dl1bz/NepControl100W/HF-100W-PA-cased-v.2.3.pdf

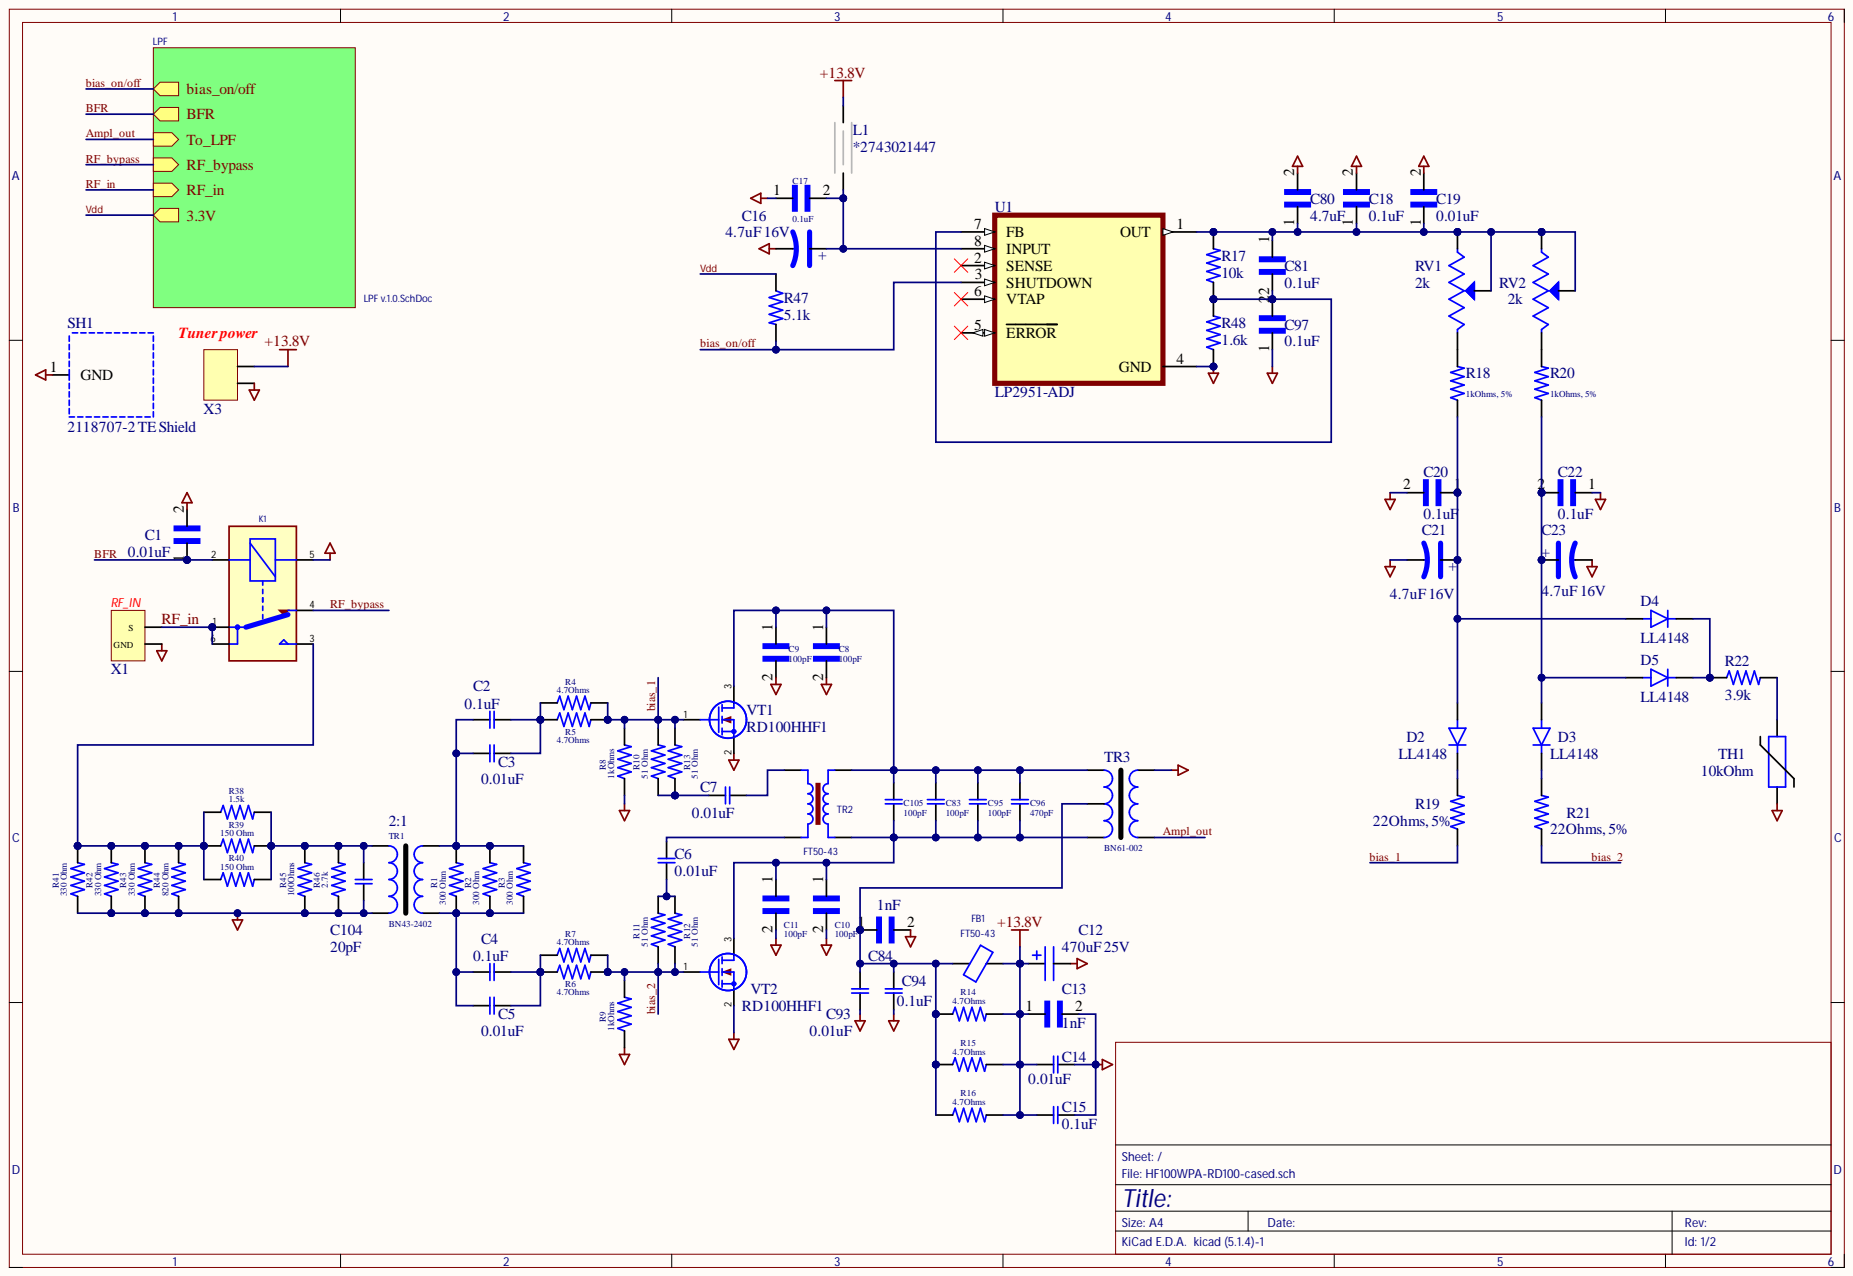
[picture p1: page 1]

SENSE 2

R47 5.1k | | VTAP 6

C105 | C83 | C95
100pF | 100pF | 100pF | 470pF

Size: A4 | Date: | Rev:
KiCad E.D.A. kicad (5.1.4)-1 | | Id: 1/2

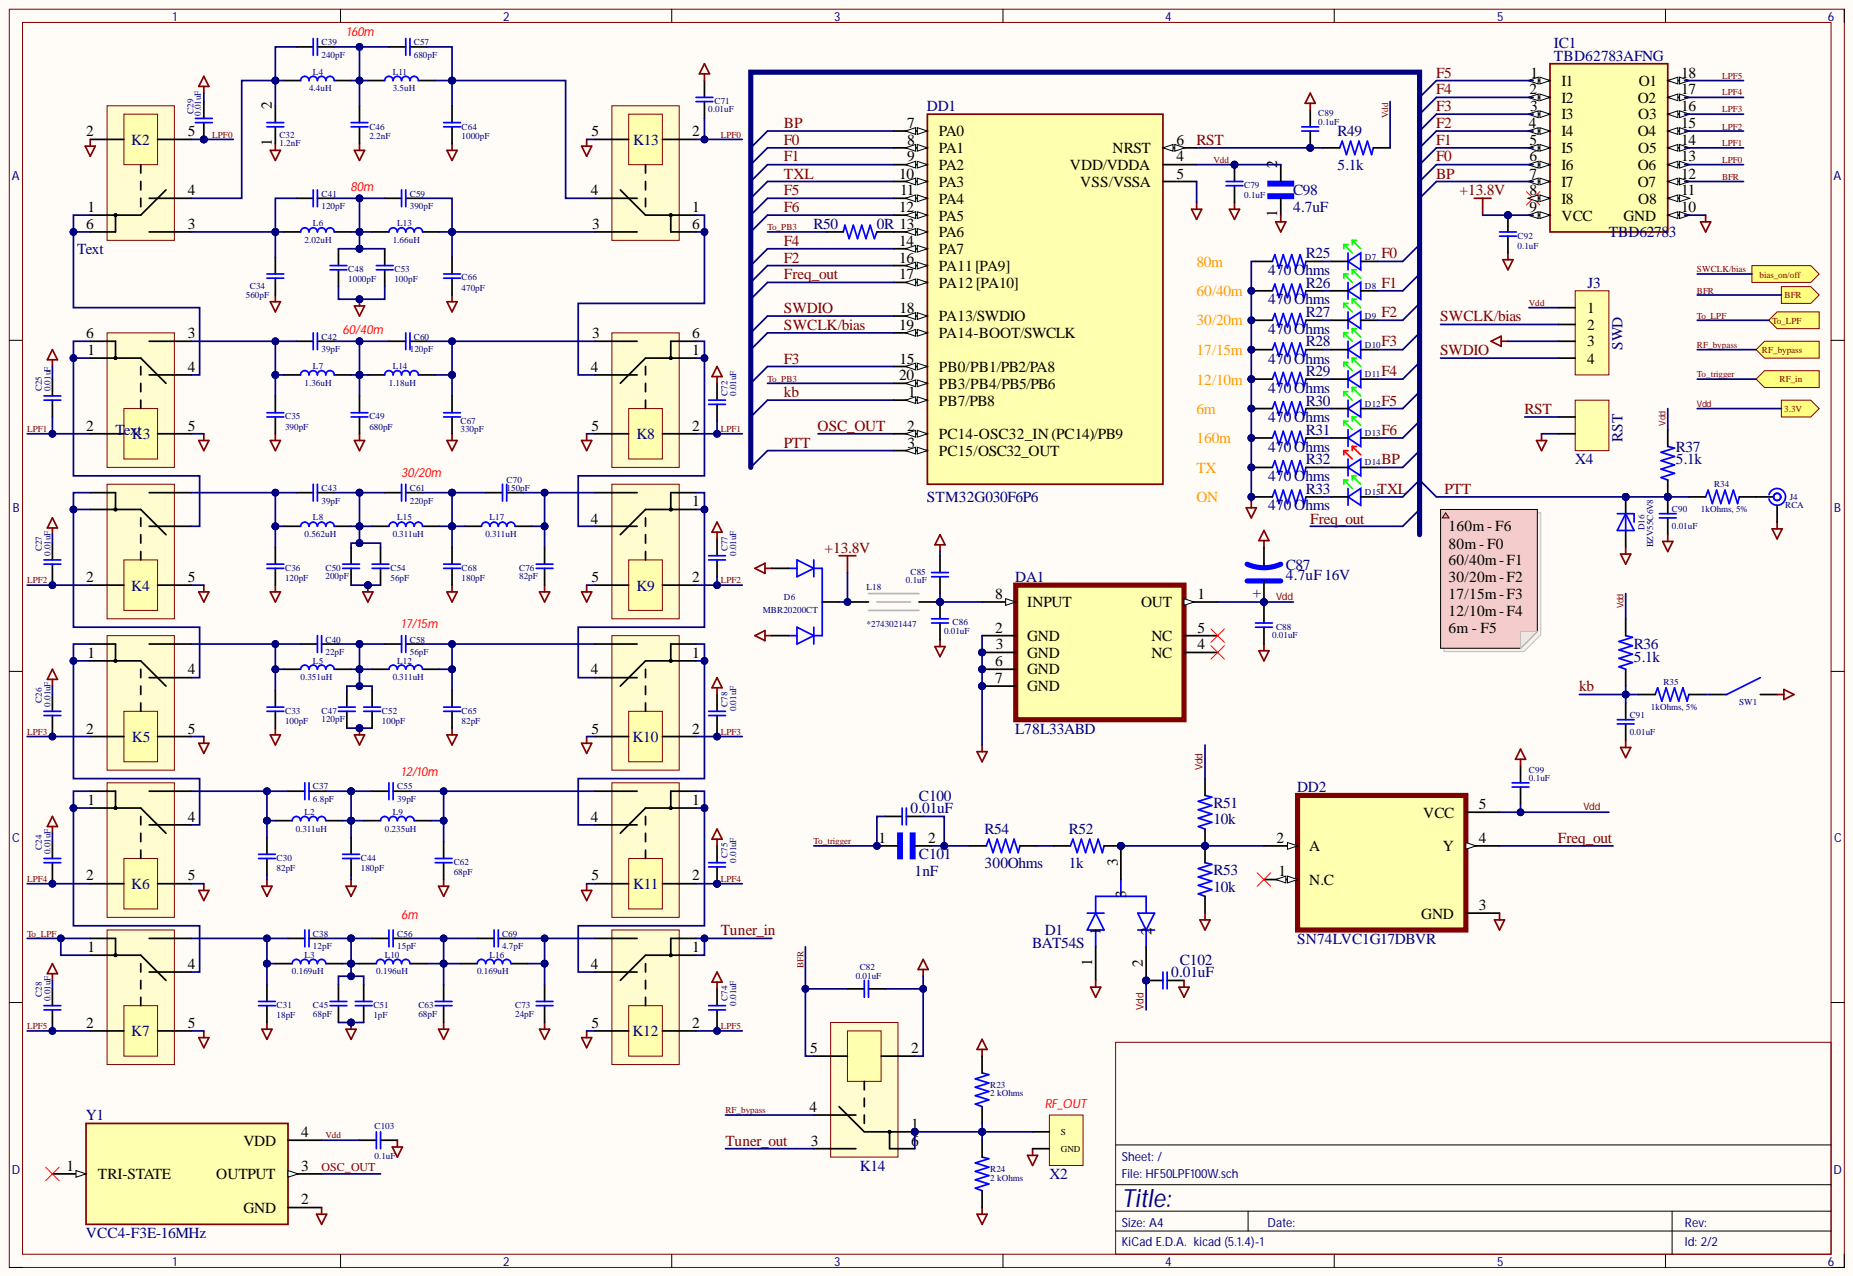
[picture p2: page 2]

Size: A4 | Date: | Rev:
KiCad E.D.A. kicad (5.1.4)-1 | | Id: 2/2
