dl1bz/NepControl100W/Neptune_100W_ESP32control.pdf

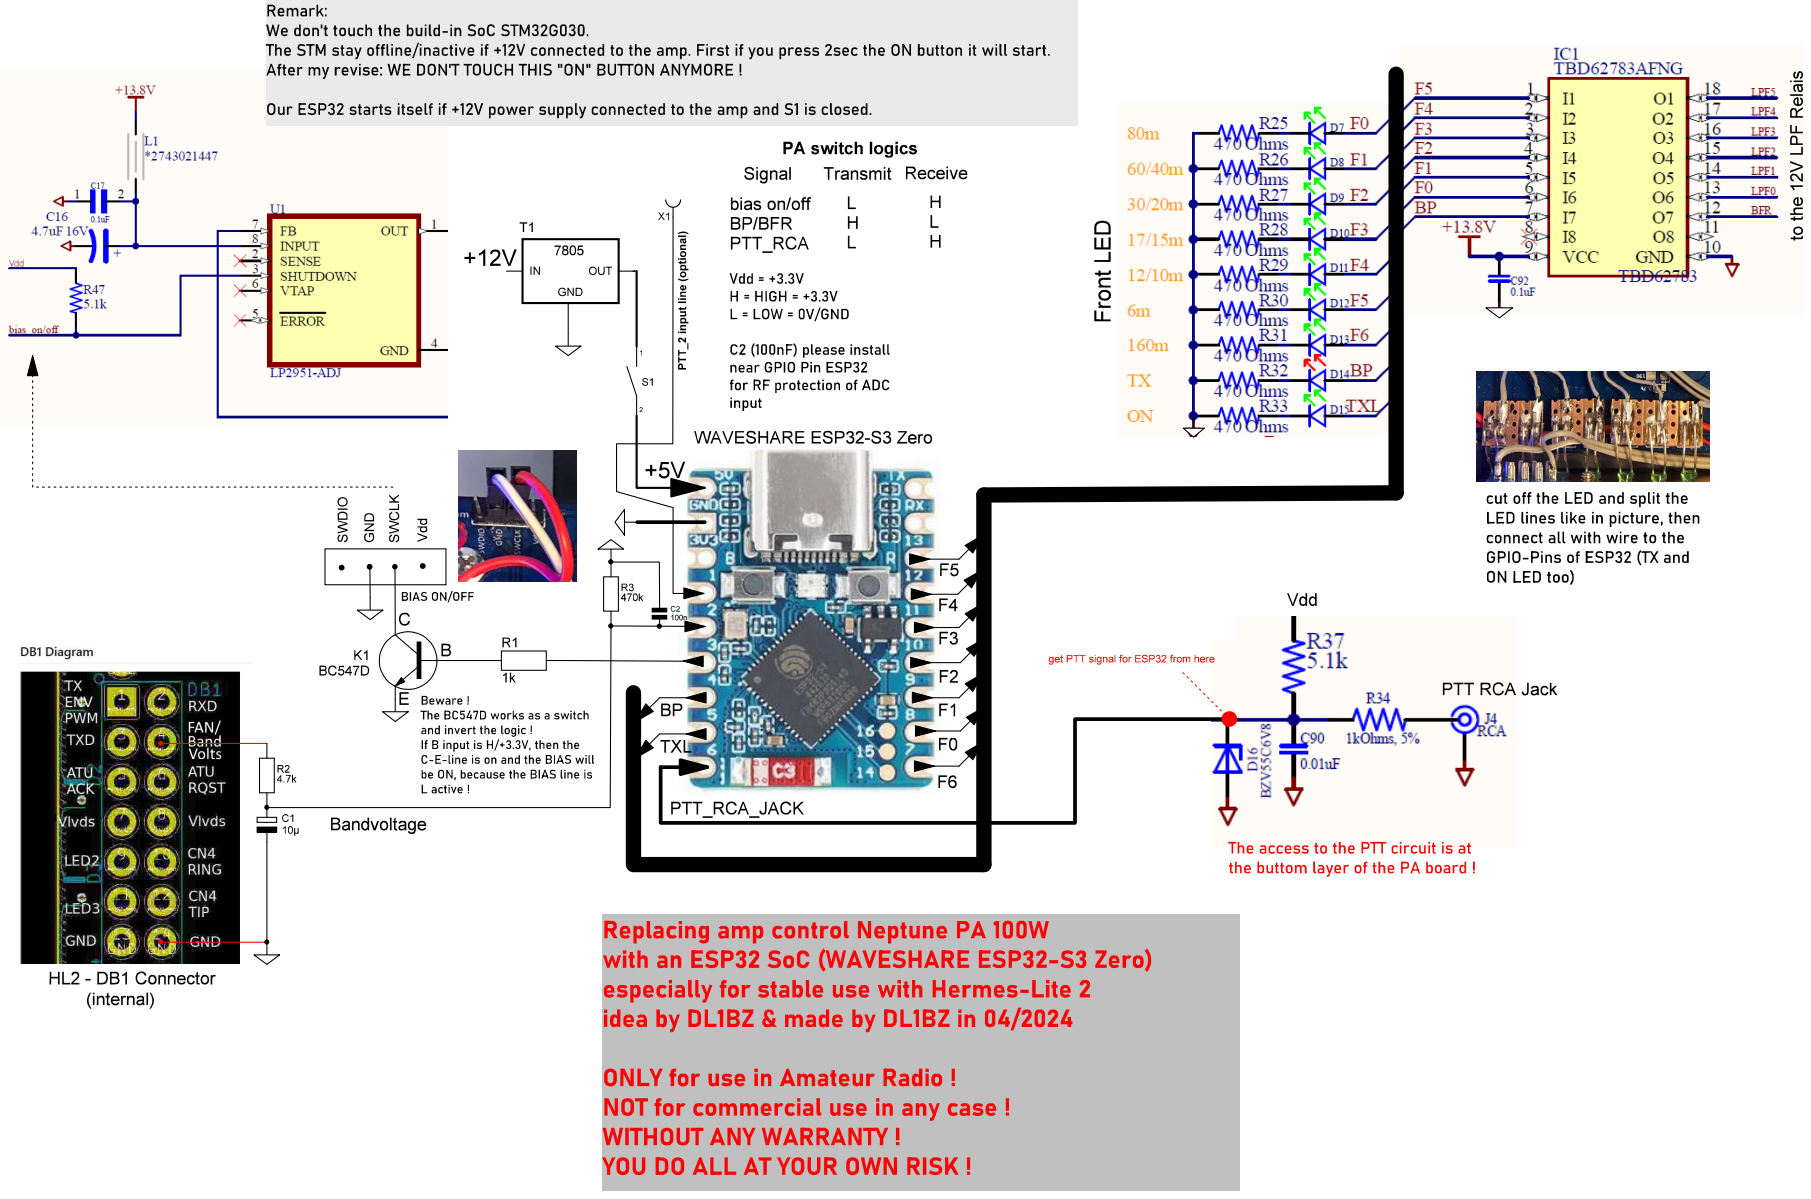
[picture p3: page 1]
